Outdatedcandy92/V3S-SBC/src/PCB/Schematic.pdf

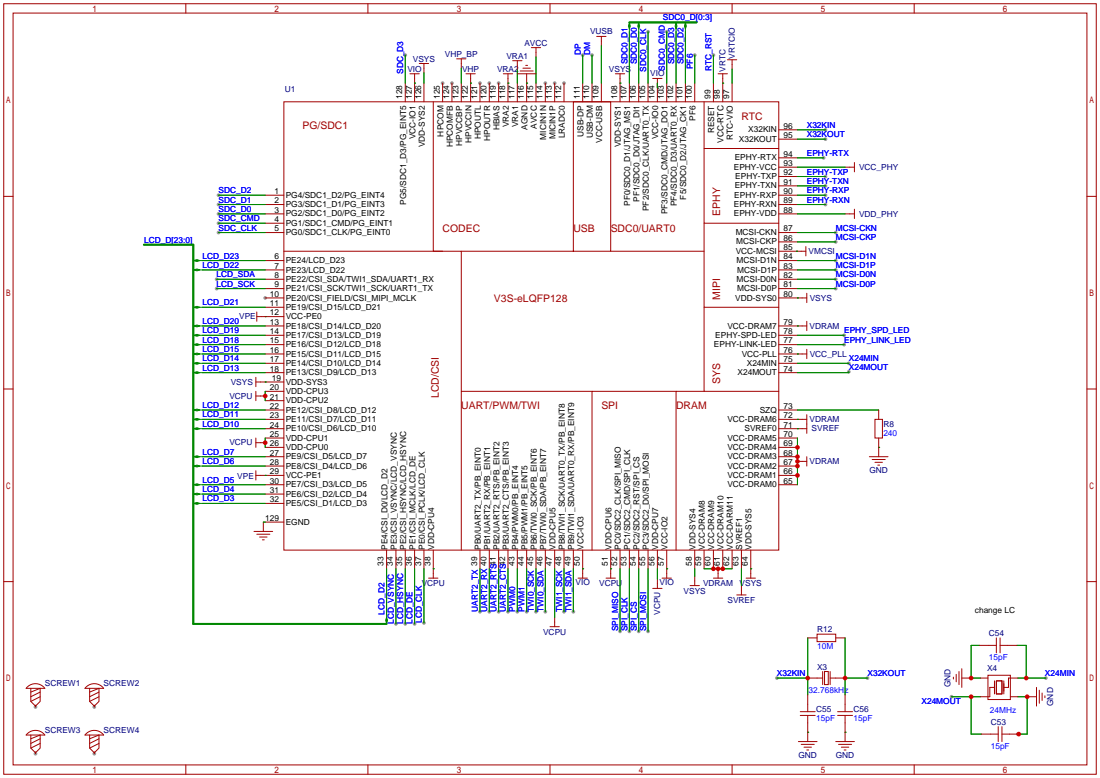
[picture p52: page 1]

VCC-DRAM0 65 VDD⁻SYS⁵ 64 SVREF1 63 VCC⁻DARM¹¹ 62 VCC⁻DRAM¹⁰ 61 VCC⁻DRAM⁹ 60 VCC⁻DRAM⁸ 59 VDD⁻SYS⁴ 58

# USB Inrush Limiter

# Power Rails

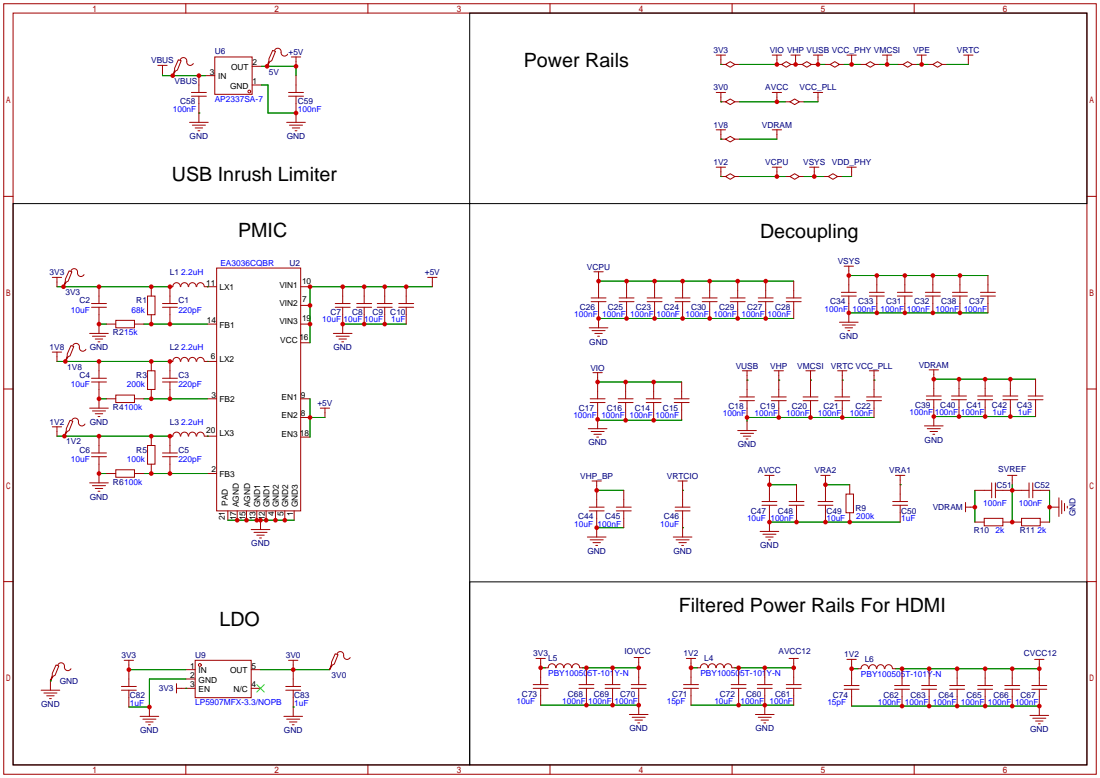
[picture p53: page 2]

Filtered Power Rails For HDMI LDO

# SHELL 11 SHELL 12 SHELL 13 SHELL 14 SHELL 15 SHELL 16 SHELL 17 SHELL 18

USB-C | SD CARD (SDC_0)

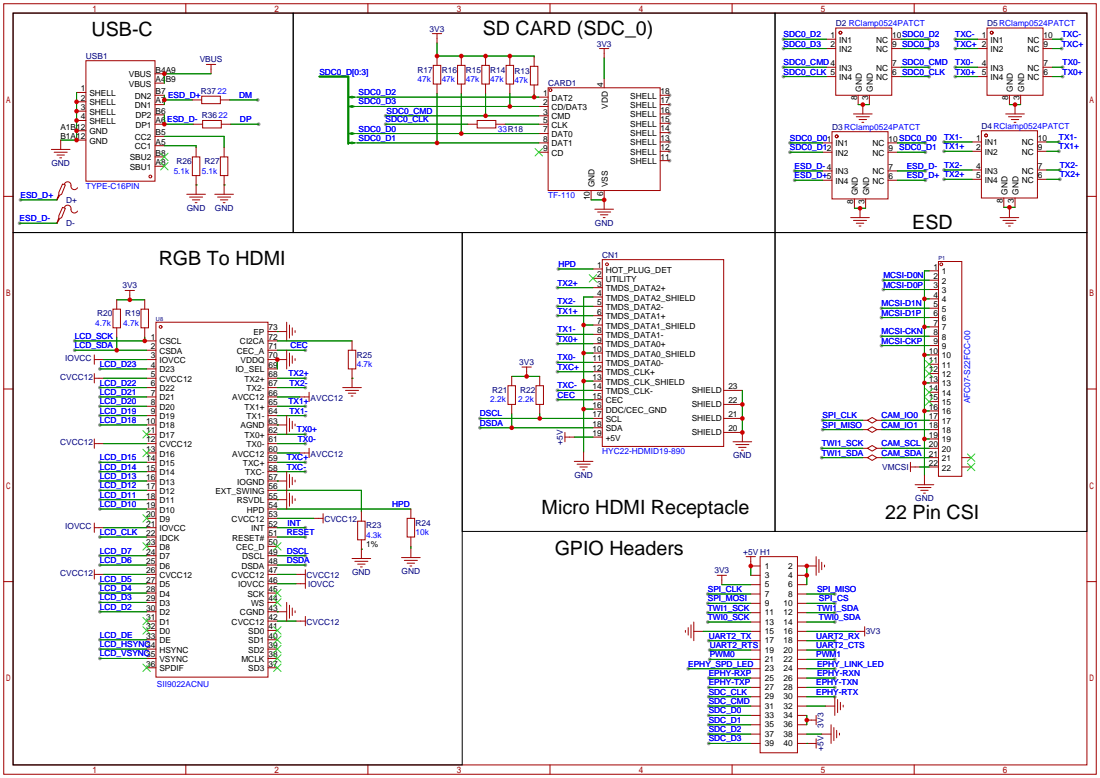
[picture p54: page 3]
