Outdatedcandy92/V3S-SBC/(list of files, drawings)

Other design files:
src/PCB/EasyEDA.epro
