Outdatedcandy92/V3S-SBC/(commit log)

2025-11-09 readme +src
    [BOM.csv, PickAndPlace.xlsx]
2025-11-09 blueprint req
    [bom.csv]
2025-11-10 source files eda
    [EasyEDA.epro]
2025-11-10 Fix bom.csv encoding - convert from UTF-16 LE to UTF-8
    [bom.csv]
2026-02-01 readme images
    [BOM.csv, EasyEDA.epro, PickAndPlace.xlsx, bom.csv]
2026-03-20 local images, updated readme with pinout
    [BOM.csv, EasyEDA.epro, PickAndPlace.xlsx, bom.csv]
